diegobastianelli/LOS-DECEPTICONS-minisumo/mecanica/README.md

Diseño 3D del chasis y la pala en PLA (pendiente).
