diegobastianelli/LOS-DECEPTICONS-minisumo/hardware/pcb/PCB_Sumo.kicad_pcb

## KiCad design hardware/pcb/PCB_Sumo.kicad_pcb (2026-10-18)

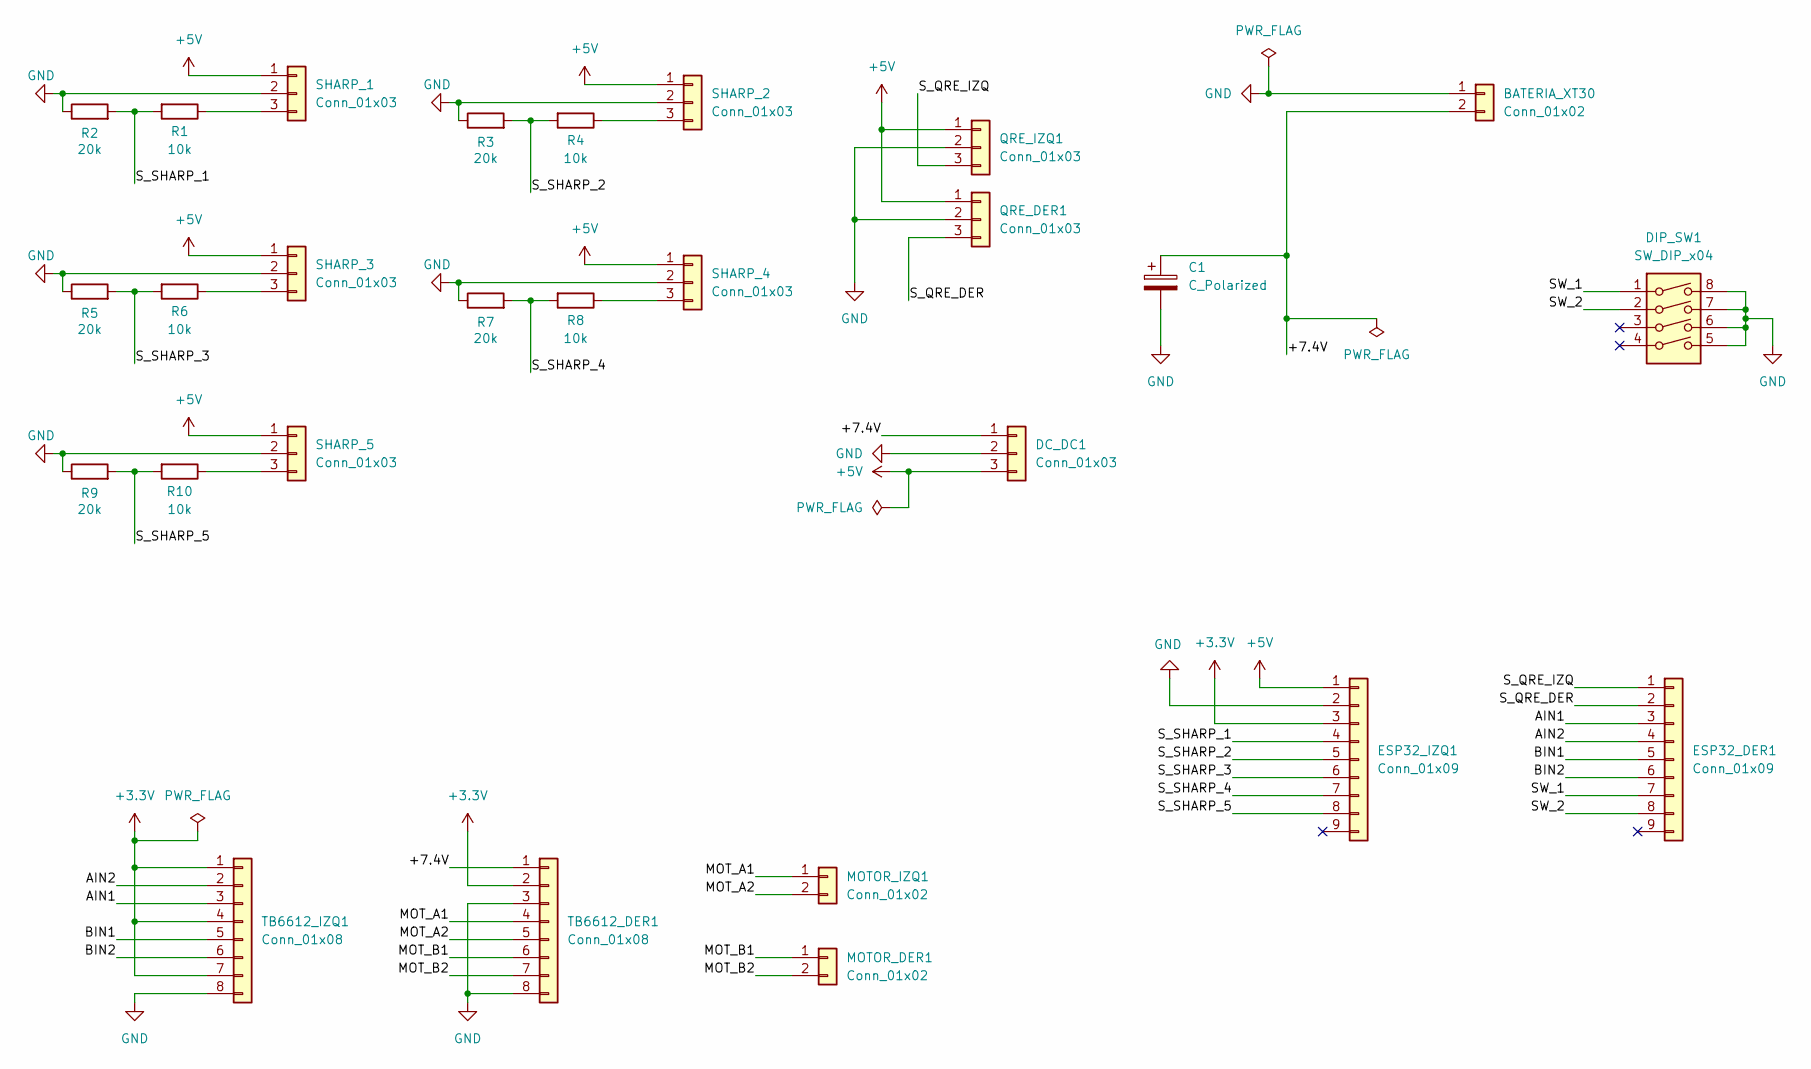
[picture p1: schematic PCB_Sumo.kicad_sch]

Parts:
BATERIA_XT30: Conn_01x02; PinHeader_1x02_P2.54mm_Vertical
C1: C_Polarized; CP_Radial_D5.0mm_P2.50mm
DC_DC1: Conn_01x03; PinHeader_1x03_P2.54mm_Vertical
DIP_SW1: SW_DIP_x04; SW_DIP_SPSTx04_Slide_9.78x12.34mm_W7.62mm_P2.54mm
ESP32_DER1, ESP32_IZQ1: Conn_01x09; PinSocket_1x09_P2.54mm_Vertical
MOTOR_DER1: Conn_01x02; PinHeader_1x02_P2.54mm_Vertical
MOTOR_IZQ1: Conn_01x02; PinHeader_1x02_P2.54mm_Vertical
QRE_DER1: Conn_01x03; PinHeader_1x03_P2.54mm_Vertical
QRE_IZQ1: Conn_01x03; PinHeader_1x03_P2.54mm_Vertical
R1, R4, R6, R8, R10: 10k; R_Axial_DIN0207_L6.3mm_D2.5mm_P10.16mm_Horizontal
R2, R3, R5, R7, R9: 20k; R_Axial_DIN0207_L6.3mm_D2.5mm_P10.16mm_Horizontal
SHARP_1, SHARP_2, SHARP_3, SHARP_4, SHARP_5: Conn_01x03; PinHeader_1x03_P2.54mm_Vertical
TB6612_DER1, TB6612_IZQ1: Conn_01x08; PinSocket_1x08_P2.54mm_Vertical

Connections:
+3.3V: ESP32_IZQ1.3, TB6612_DER1.2, TB6612_IZQ1.1, TB6612_IZQ1.4, TB6612_IZQ1.7
+5V: DC_DC1.3, ESP32_IZQ1.1, QRE_DER1.1, QRE_IZQ1.1, SHARP_1.1, SHARP_2.1, SHARP_3.1, SHARP_4.1, SHARP_5.1
/+7.4V: BATERIA_XT30.2, C1.1, DC_DC1.1, TB6612_DER1.1
/AIN1: ESP32_DER1.3, TB6612_IZQ1.3
/AIN2: ESP32_DER1.4, TB6612_IZQ1.2
/BIN1: ESP32_DER1.5, TB6612_IZQ1.5
/BIN2: ESP32_DER1.6, TB6612_IZQ1.6
/MOT_A1: MOTOR_IZQ1.1, TB6612_DER1.4
/MOT_A2: MOTOR_IZQ1.2, TB6612_DER1.5
/MOT_B1: MOTOR_DER1.1, TB6612_DER1.6
/MOT_B2: MOTOR_DER1.2, TB6612_DER1.7
/SW_1: DIP_SW1.1, ESP32_DER1.7
/SW_2: DIP_SW1.2, ESP32_DER1.8
/S_QRE_DER: ESP32_DER1.2, QRE_DER1.3
/S_QRE_IZQ: ESP32_DER1.1, QRE_IZQ1.3
/S_SHARP_1: ESP32_IZQ1.4, R1.2, R2.2
/S_SHARP_2: ESP32_IZQ1.5, R3.2, R4.2
/S_SHARP_3: ESP32_IZQ1.6, R5.2, R6.2
/S_SHARP_4: ESP32_IZQ1.7, R7.2, R8.2
/S_SHARP_5: ESP32_IZQ1.8, R9.2, R10.2
GND: BATERIA_XT30.1, C1.2, DC_DC1.2, DIP_SW1.5, DIP_SW1.6, DIP_SW1.7, DIP_SW1.8, ESP32_IZQ1.2, QRE_DER1.2, QRE_IZQ1.2, R2.1, R3.1, R5.1, R7.1, R9.1, SHARP_1.2, SHARP_2.2, SHARP_3.2, SHARP_4.2, SHARP_5.2, TB6612_DER1.3, TB6612_DER1.8, TB6612_IZQ1.8
unnamed: R1.1, SHARP_1.3
unnamed: R4.1, SHARP_2.3
unnamed: R6.1, SHARP_3.3
unnamed: R8.1, SHARP_4.3
unnamed: R10.1, SHARP_5.3

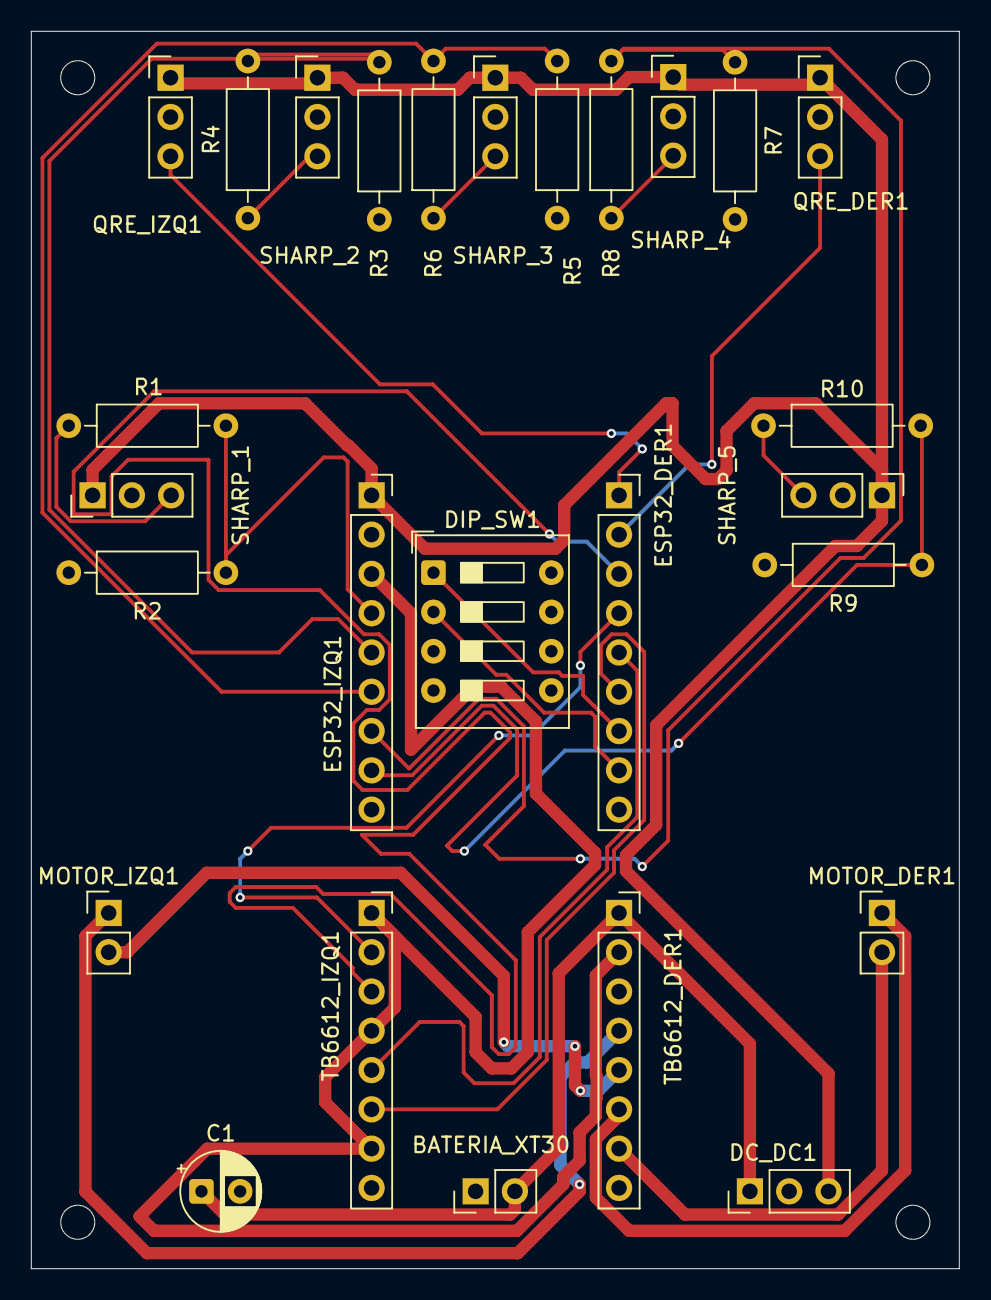
[picture p2: board PCB_Sumo.kicad_pcb from above]

Board: 2 copper layers, 60.0 x 80.0 mm, 27 parts (0 on the bottom side), 26 nets.
